HayMayia/Data/PROGRESS_LOG.md

# VocalBridge — Progress Log (continuation)

Updated: 12 Oct 2026 — HelpDetect V2.0 shipped (the sense -> speak merge).

## ✅ DONE 12 Oct — V2.0 closes the loop. This is the "v13" that was planned on 5 Sep and never built.
The 5 Sep NEXT STEPS list said, item 4:
> **Build v13** = clench detector + spoken "Help" through the MAX98357A (merge v11
> state machine + the playHelp() function from SpeakerSayHelp). Then: squeeze ->
> CLENCH! + "Help!". Film it (Phase-1 demo complete).

That merge never happened. It is done now — with one deliberate upgrade. The plan
was to merge the **v11 clench** state machine, but the project moved well past
clench detection in the six sessions since: HelpDetect V1.9 has a peak x duration
**word box** tuned on real HELP data, with auto-learn and flash persistence. So
V2.0 merges V1.9 (not v11) with the speaker. Same idea as v13, better detector.

Why this was the right gap to close — two firmware lines existed and never met:

| | senses the word | speaks it aloud | triggered by |
|---|---|---|---|
| `HelpDetect_AD8232` V1.9 | YES (tuned box + auto-learn) | NO — serial print only | the muscle signal |
| `SpeakerSayWords_MAX98357A` V5 | NO | YES (own voice, on-chip) | a keypress on a laptop |

Neither alone is VocalBridge. A sensed HELP now plays the 2-beep alert and says
"HELP!" in the user's own voice, standalone — no laptop, no Serial Monitor, no SD card.

How it was built (deliberately conservative):
- Audio engine + all four voice headers copied **verbatim** from V5, the build already
  verified on the real speaker. Nothing unproven was introduced. The hardware is
  confirmed good: 5 Sep logged "EXCHANGED BOARD WORKS... 'Help!' voice CONFIRMED
  WORKING too" after the original MAX98357A turned out to be a defective unit.
- Pins match the standardised wiring from 5 Sep exactly — BCLK 27 / LRC 26 / DIN 25,
  sensor OUT 34 / LO+ 32 / LO- 33. The 5 Sep note "no clash with sensor on 34" holds.
  LRC is on 26, **not** 33, so the "LO- must move to GPIO35" caveat does not apply.
- Detection logic **untouched**. `diff` vs V1.9 = 233 added / 10 removed lines, and
  every one of the 10 removed lines is comment or banner text. Same box
  (800-2000 x 150-1100 ms), same auto-learn, same flash save, same calibrate.
- Verified by compiling AND linking on **both** esp32 core paths (v2 `driver/i2s.h`,
  v3 `ESP_I2S.h`) against an Arduino/ESP32 stub harness: 0 errors, 0 warnings, and
  `setup()`+`loop()` execute clean. Harness sanity-checked by confirming known-good
  V1.9 passes it identically.
- Voice headers are `.h`, not `.ino`, so they sit safely in the sketch folder — the
  5 Sep warning that the Arduino IDE merges all `.ino` files in one folder does not bite.
- **NOT yet device-verified.** Standing rule: the user tests every build on the real
  speaker before it counts. That test is still outstanding.

New keys in V2.0 (all V1.9 keys unchanged, including `+/-` = HELP box edge):
- `1`/`2`/`3`/`4` say HELP/WATER/YES/NO by hand — speaker self-test and demo fallback
- `b` beep — fastest "is the speaker alive" check; splits "audio dead" from "never fired"
- `m` mute/unmute — for tuning and the statue test, when audio would only distract
- `[` `]` volume down/up (`+/-` were already taken by the box edge in V1.9)
- `t` test now prints **and** speaks, making it a true end-to-end check
- Boot still proves the audio path: 2 beeps + "HELP!" after 2 s, as V5 did

Engineering note — why playback needs a deaf window: `playClip()` blocks the loop for
~1.4 s, so ADC sampling stops, `env` goes stale, and the speaker's own vibration can
reach the pads. After every word V2.0 drops any burst in progress, keeps sampling so
`center` keeps tracking, refuses to open a new burst for `SPEAK_HOLD_MS` (600 ms), and
runs the 1500 ms refractory from the **end** of speech. Without this the device would
hear itself speak and re-trigger — the same class of self-inflicted false fire that
sessions 3 and 5 were ruined by.

## ✅ DONE 12 Oct — logs are now replayable offline
The log line gained two fields: `burst:` (the calibrated gate `burstLvl`) and `box:`
(the live peak x duration box). Older logs never recorded `burstLvl`, so sessions 1-6
could not be re-analysed offline without guessing the gate. Guessing fails badly: a
replay at any fixed gate merges everything into one enormous burst (measured apparent
durations of 20 500 ms — obviously not a word), and the reconstructed HELP count comes
out ~5x the real figure. Fields were appended, so the format stays backward-compatible.

## ⏭️ NEXT STEPS (in order)
1. **Flash V2.0 and confirm the speaker fires on a sensed HELP.** The one thing that
   cannot be done without hardware. Expect 2 beeps + "HELP!" at boot (that alone proves
   the audio path). Then `c` -> `CALIBRATE OK`, then say HELP -> expect the print *and*
   the voice. Prints but silent? press `b`, and check `m` is not muted.
2. Keep speaker wires away from pad wires — speaker current injects noise into the
   AD8232 (long-standing warning, still true).
3. **Collect WATER/YES/NO data.** Still COLLECT-ONLY, because there is nothing to build
   a box from: `Values.txt` (session 6) has 18 `MARK:HELP` and **0** `MARK:WATER`,
   `MARK:YES`, `MARK:NO`. Sessions 1-6 are HELP-only. Protocol (~10 min) is in
   ROADMAP.md. This is what finally stops "everything is HELP".
4. **Film the Phase-1 demo** — squeeze/say HELP -> device speaks. That was the point of
   v13 back on 5 Sep and is now reachable.
5. Then Phase 2: the "Tesla update" demo, adding PAIN over the air via ESP-NOW OTA.

---

## Historical entry — night of 5 Sep 2026 (speaker session, last one before exam week)

## 🔧 CURRENT DEBUGGING STATE (speaker wiring)
- LRC path FIXED (tone changes audible = BCLK/LRC/DIN all decoding). Which fix worked
  (fresh wire vs GPIO33) — still to be confirmed by user.
- Constant raspy/garbled sound **unchanged by the 256-step sine upgrade** → garble is
  PHYSICAL (marginal joint), not code. Suspect #1: amp header pins (possibly unsoldered
  from factory, like their AD8232 was).
- **NOW: user re-soldered the driver board — NO CHANGE.** Suspects remaining:
  ① speaker itself (battery pop test: wires on a 1.5V AA, clean pop = OK)
  ② amp clipping (volume `-`×5 test; fix = volume ≤8 or GAIN→VIN = 0dB)
  ③ dud amp clone (if ① ② pass → replace board)
- **✅ SOLVED (5 Sep, late): EXCHANGED BOARD WORKS.** Clean chime on SpeakerTest.
  The original unit was defective (lemon) — diagnosis chain (LRC isolation → re-solder
  → code fixes → exchange) validated. **"Help!" voice CONFIRMED WORKING too.**
- **Audio tuning (5 Sep, night):** user wanted louder + crisper →
  ① help_sound.h rebuilt as LOUD+CRISP edition (+4.7 dB loudness, HPF 170 Hz,
  presence +4.5 dB @ 2.6 kHz, soft limiter; same voice take). make_help_header.py
  now applies this chain automatically. Preview: audio/help_enhanced.wav.
  ② advised GAIN→GND wire (+3 dB) + VIN-on-5V check + speaker-in-a-box acoustic tip.
- ⚠️ IMPORTANT: the code pasted in chat (Sep 5) predates the APLL patch. For the new
  board, download the latest sketches from the `beep` branch on GitHub.
- Older context: garble with LRC dangling + all 6 Wire Doctor mappings failing →
  buzz splitter test isolated the fault to the LRC path (power/amp/speaker/BCLK/DIN
  were all confirmed good).
- When GPIO33 is taken by LRC, the muscle sensor's LO− moves to GPIO35 later.
- **Audio v5→v6 (mid-Sep):** v5 (STRETCH 3.0) reached the wanted slowness (2.64 s) but
  CACKLED — 3× exceeds the simple WSOLA's clean range. v6 fix: regenerate the take
  natively slow via elongated spellings ("Heeeelp! Heeeeelp, pleeeeease!", voice-02,
  1.49 s speech) + gentle 1.75× stretch → 2.81 s, RMS −8.1 dBFS, artifact delta +0.28%
  (clean). LESSON: keep stretch ≤ ~2×; make the source itself slow instead.
- **🔔 REVELATION (18 Sep):** user had been judging audio via the PREVIEW WAV on the
  COMPUTER — never uploaded anything after v5. Explains everything: v6/v7/v8 previews
  share the same take+speed (only ~1 dB deltas) → "sound is the same" was CORRECT on
  a computer; "weird on computer" = the speaker-mastered preview (18 dB compression
  + presence EQ) sounds harsh on full-range speakers BY DESIGN — it's mastered for
  the 2-inch driver + amp. Alarm beeps live in CODE, not in the preview.
  → Added audio/help_preview_natural.wav (same speed, no mastering) for fair listening.
  NEXT: user picks v10 variant by ear (computer previews), uploads that zip.
- **Audio v11 (23 Sep):** user verdict on v10: good but ① only the word "HELP"
  ② slight warble remains ③ 2.8x = "unnaturally slow, on purpose". v11: single
  plain "HELP" take (all 6 single-word TTS takes ~0.32s regardless of spelling —
  engine caps it) stretched only 1.8x → 0.77 s natural call pace, PV warble floor.
  Own-voice instructions added to guide (chat path + offline path). Single-word
  takes kept: audio/word_help1..6.wav (help6 = chosen, saved as help_single.wav).
- **Audio v10 (18 Sep):** user: "words slower, not the silence" → implemented a pure-
  python PHASE VOCODER (FFT + phase propagation + Laroche-Dolson identity phase
  locking) — the professional time-stretch. Two variants built from the two healthy
  takes (all 8 other TTS takes today were duds/punctuation-ignored — dud-rejection
  now in script): v10 classic ("Help! Help, please!" ×2.8, 2.49 s) and v10 help-me
  ("Please, help me! Help me!" ×2.6, 2.92 s, peak 0.83 take). Roughness + pitch-jitter
  metrics: PV ≈ WSOLA ≈ original (both clean by measurement); user's ears decide.
  Script now takes CLI args: take, stretch, out-header, version string.
- **Audio v9 (18 Sep, final approach):** user feedback on natural preview: elongated
  take "not the voice I chose" + still cackly → root causes: ① elongated spelling
  changes pronunciation character ② WSOLA on long vowels warbles ③ (hidden) all three
  new "pause" TTS takes were near-silent DUDS (peak 0.05-0.10). FIX: recovered the
  user-approved v3 take ("Help! Help, please!", peak 0.70) from git history,
  inserted 850 ms silence at detected word-boundary valleys — natural words, slow
  phrase, ZERO stretch. 2.56 s, active RMS −5 dB. Added dud-rejection (peak<0.25 =
  error) to make_help_header.py. help_voice_v9.h + SpeakerSayHelp_v9.zip pushed. (Earlier v8 countermeasures — new filename, boot banner with
  compile stamp, alarm intro, RMS −6.4 dBFS, volume 15 — all still apply and are
  exactly what makes the on-device test unambiguous.)
- **Status (mid-Sep):** audio system DONE (loud+crisp "Help!" confirmed). Exams nearly
  over (only Computers left). Next session: fresh pads → v13 (clench → "Help!") → film.

## 📍 Where the project stands

### ✅ DONE (previous sessions)
- **4095 saga solved** — root cause was floating OUTPUT wire / loose cable; soldered
  headers fixed it. Healthy AD8232 @3.3V reads ~2047 at rest (our "green light").
- **Electrodes** — green/RL on elbow bone (required), red+yellow on the same forearm
  muscle belly. LO+/LO- leads-off detection wired to GPIO32/33 and confirmed.
- **Muscle detection works** — clench shows up as slow baseline shift, dev up to 682
  (ball squeeze) / 1890 (max) vs rest noise ~39.
- **ClenchDetector v10** (ARMED→CLENCH!→SETTLE→re-ARM state machine) — works.
- **ClenchDetector v11** (weak-signal edition: 0.3 s windows, 2-quick-lines OR
  big-spike ≥3× threshold instant fire) — ready for dried-pad sessions.
- Full documentation set exists from the earlier session (SFVIP-format report, BOM,
  build guide, poster, video script, teammate guide, academy quiz site).

### 🆕 THIS SESSION (5 Sep, night)
User request (was rejected by the AI service last time, answered now):
> "give me a code to test if my speaker works using the provided speaker module and the driver"

**Hardware discovery:** the user's actual audio parts (from their own Amazon links in an
earlier chat) are a **MAX98357A I2S amplifier** (B0H99FVF3V) + **2″ 4Ω 5W speaker**
(Electronic Spices, B0BN44HPF9). NOT a DFPlayer — no microSD, no MP3 player, and
**digital input only** (a plain GPIO tone test gives silence on it).

Created `vocalbridge-speaker/`:
| File | Purpose |
|---|---|
| **`SpeakerTest_MAX98357A.ino`** | **The speaker test for THEIR board.** I2S beeps (880/440 Hz chime with click-free fades), no library, auto-detects esp32 core v2/v3. BCLK=27, LRC=26, DIN=25 (no clash with sensor on 34). Commands: b/+/-/h. |
| **`SpeakerWireDoctor.ino`** | **Wiring self-diagnosis.** For the "garbled sound that dies when LRC is plugged in" case: cycles 6 BCLK/LRC/DIN pin arrangements in software (swaps + one-hole shifts), chimes after each. When the chime is clean, the printed mapping = the actual wiring. No rewiring needed to diagnose. |
| **`SpeakerSayHelp_MAX98357A.ino`** | **Speaker SPEAKS "Help!"** — real voice clip embedded in the ESP32 flash (`help_sound.h`, AI voice chosen by the user in chat, 24 kHz mono 0.47 s, silence-trimmed + normalized). No SD card, no library. Commands: h play / 2 double / l loop / +− volume / b beep / i info. |
| `make_help_header.py` | Regenerates `help_sound.h` from `audio/help.wav` — lets the user put **their own voice** into the device. Tested working. |
| `SpeakerTest_DFPlayer.ino` | Plan B if a DFPlayer Mini is ever bought: status report, auto-play, serial commands, decoded errors. |
| `SpeakerTest_Tone_Amp.ino` | Plan C for plain analog amps (PAM8403 etc.): beep test. Does NOT work on MAX98357A (digital-only). |
| `ClenchDetector_v12_SPEAKER.ino` | v11 + DFPlayer = full Phase-1 demo **for the DFPlayer path**. Speaker optional at runtime. |
| `SPEAKER_TEST_GUIDE.md` | Start here: identify module (MAX98357A = Plan A = theirs), wiring, troubleshooting, EMG noise rules, next-week plan. |

### Key wiring standardized this session
```
MAX98357A (their board):  VIN->VIN(5V)  GND->GND  BCLK->GPIO27  LRC->GPIO26  DIN->GPIO25
                          SD & GAIN unconnected; speaker -> + / - output
DFPlayer (if ever bought): VCC->VIN(5V) GND->GND RX->GPIO26 TX->GPIO27 (crossed!)
                          Speaker -> SPK_1 + SPK_2 (never GND); SD: FAT32 /mp3/0001.mp3…
```

## ⏭️ NEXT STEPS (after exams)
1. Wire MAX98357A (5 wires + speaker) → run `SpeakerTest_MAX98357A.ino` → hear chime.
2. Run `SpeakerSayHelp_MAX98357A.ino` → hear the device SAY "Help!" ✅ (voice is on-chip)
3. **Fresh pads**, clench test again with v10/v11 → confirm CLENCH! still fires.
4. **Build v13** = clench detector + spoken "Help" through the MAX98357A
   (merge v11 state machine + the playHelp() function from SpeakerSayHelp).
   Then: squeeze → CLENCH! + "Help!". Film it (Phase-1 demo complete).
   Optional: generate Yes/No/Water/Pain voice clips the same way.
5. Then the real VocalBridge goal: jaw clench / swallow / tongue press with pads
   under the chin — check if those give a usable dev too.
6. Package updates: BOM, build guide, poster, report, video script (all exist;
   update with the MAX98357A speaker section).

**Note:** every sketch now lives in its own subfolder (Arduino IDE merges all .ino
files in one folder into one sketch — that would break the build).

## 🔍 HARDWARE AUTHENTICITY AUDIT (5 Sep, via Amazon listings)
- **MAX98357A board (B0H99FVF3V)**: Brand "**Generic**", ₹269 (fake MRP ₹399). Generic
  Chinese breakout (Adafruit-design copy — legal/normal). Chip authenticity lottery;
  theirs distorts constantly despite soldering + code fixes → **likely defective unit /
  reject-grade chip. ACTION: claim Amazon 10-day defective replacement, or pivot to
  DFPlayer Mini (code ready) / branded board (ROBODUINO, Robocraze SmartElex).**
- **Electronic Spices 2″ 4Ω 5W speaker (B0BN44HPF9)**: genuine Indian budget brand,
  ₹143, sold via Clicktech/Amazon — not fake, just cheap. Battery pop test = final check.
- **AD8232 (red SparkFun-style board)**: design clone (normal in India) but PROVEN
  working — rest ~2047, clench dev 682, leads-off OK. Fine.
- **ESP32 DevKit**: proven working across all sessions. Fine.
- **Spandan (Sunfox) ECG electrodes**: genuine medical brand. Fine (drying = normal wear).

## 📁 File history (for archaeology)
- `workspace-01a06757…/` (earlier session): docs, poster, report, academy, BOM+speaker plan
- `workspace-01a06d50…/` (4 Sep session): ADC_SelfTest, MuscleTest v2–v4,
  ClenchDetector v5–v11, VocalBridge_4095_FIX.md
- `vocalbridge-speaker/` (this session): speaker tests + v12 + guide
