HayMayia/Data/sensing_data/2026-09-29_session2_falsefires_vs_word_chart.png

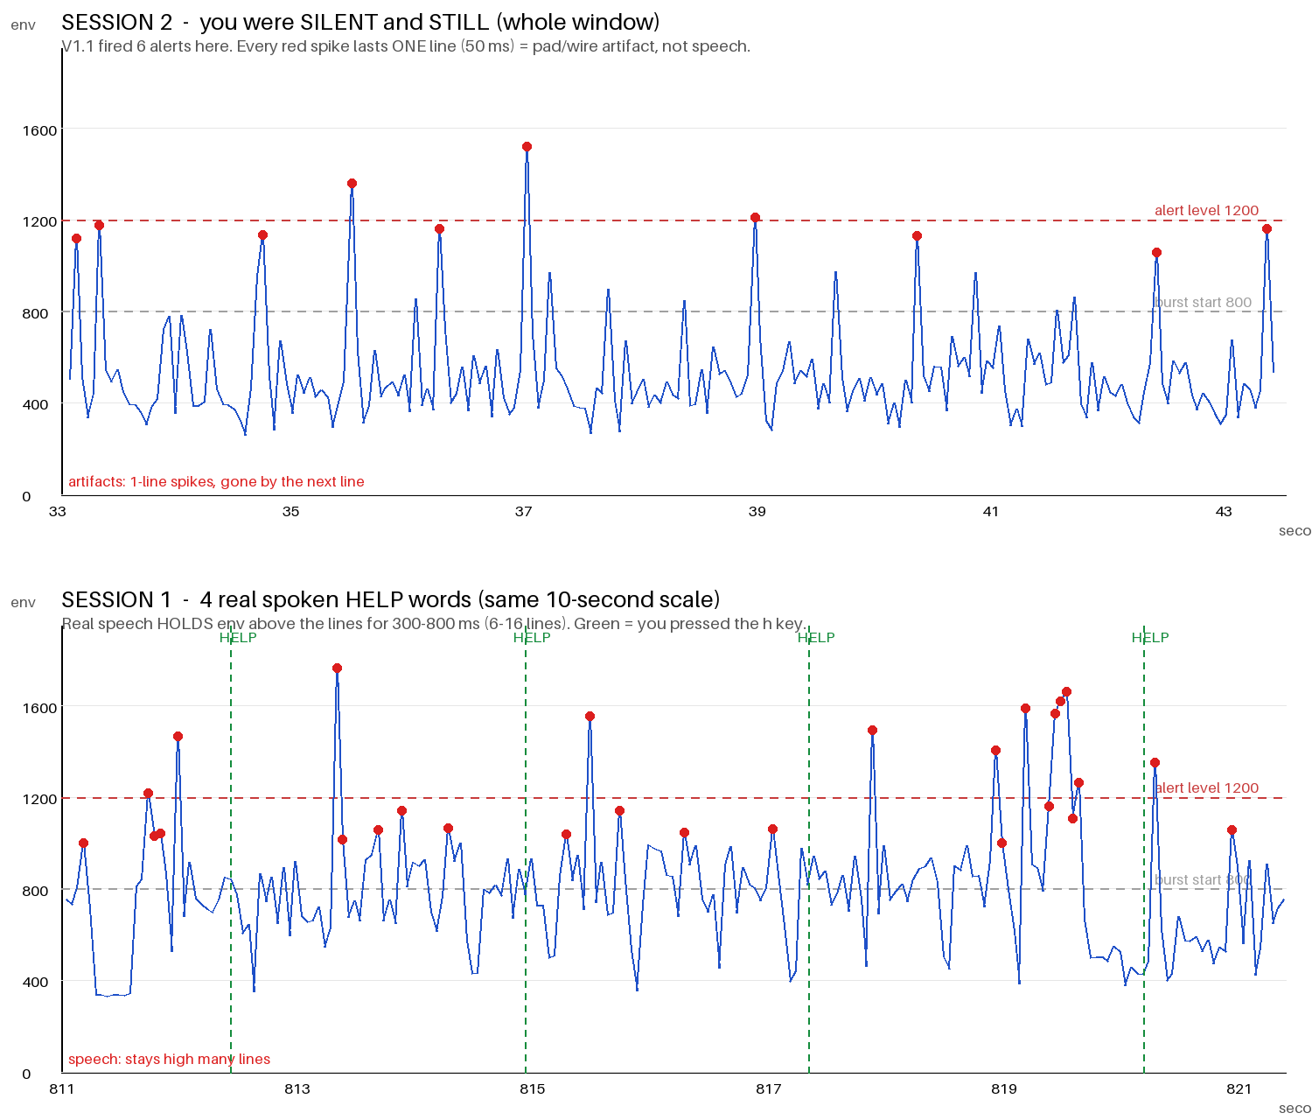
sensing_data/2026-09-29_session2_falsefires_vs_word_chart.png
