HayMayia/Data/sensing_data/2026-09-29_session3_neck_vs_session1_collarbone_chart.png

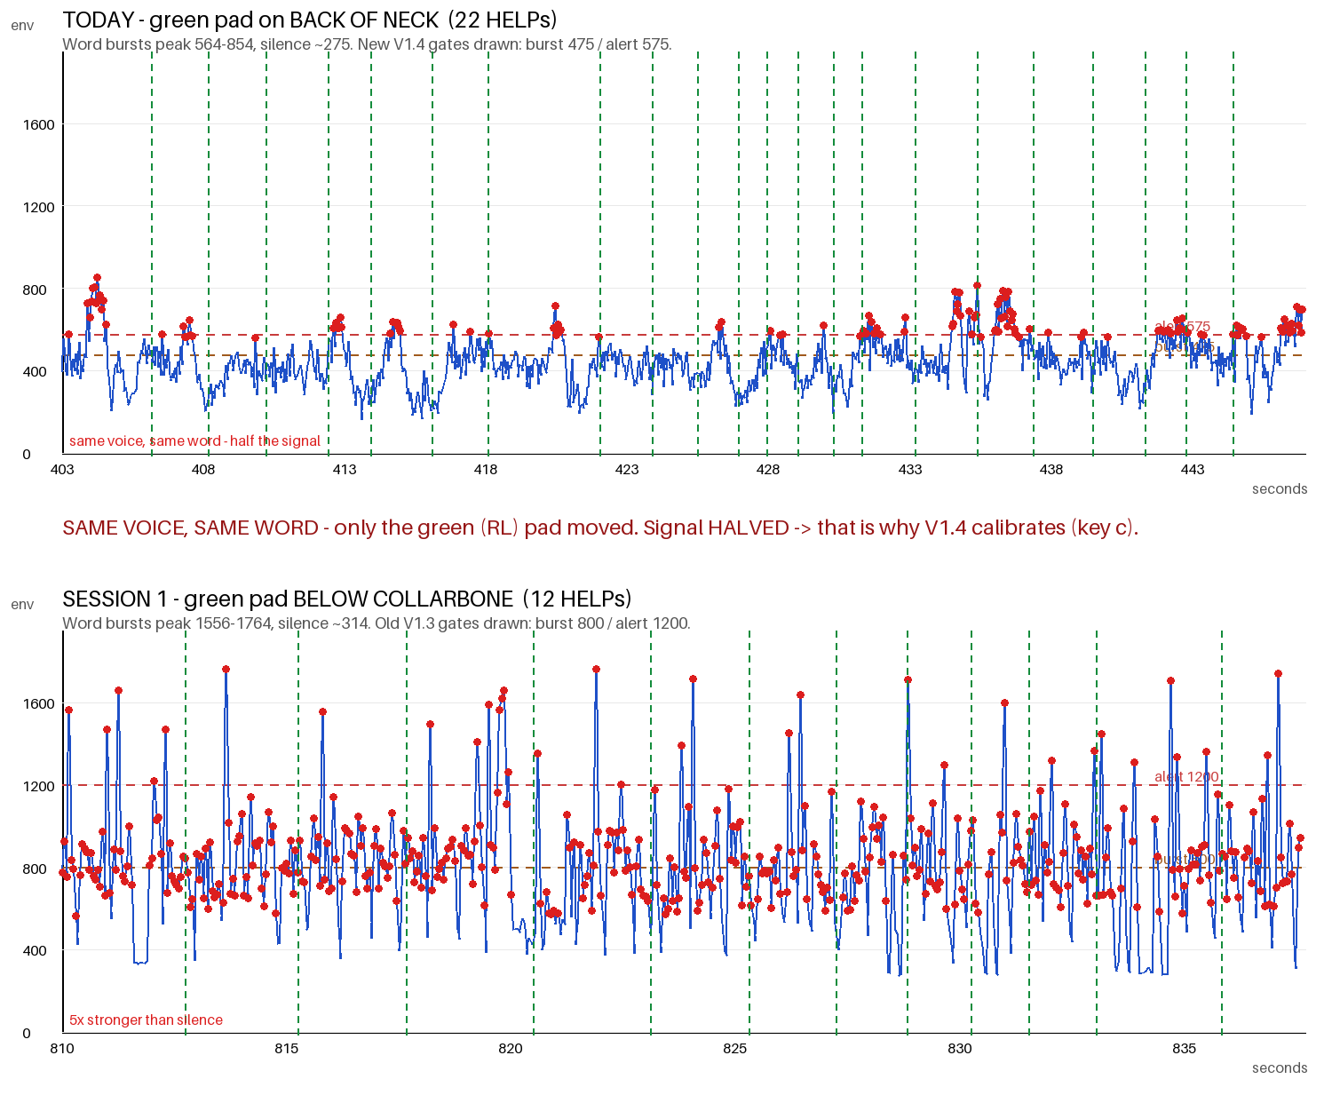
sensing_data/2026-09-29_session3_neck_vs_session1_collarbone_chart.png
