HayMayia/Data/sensing_data/session1_HELP_chart.png

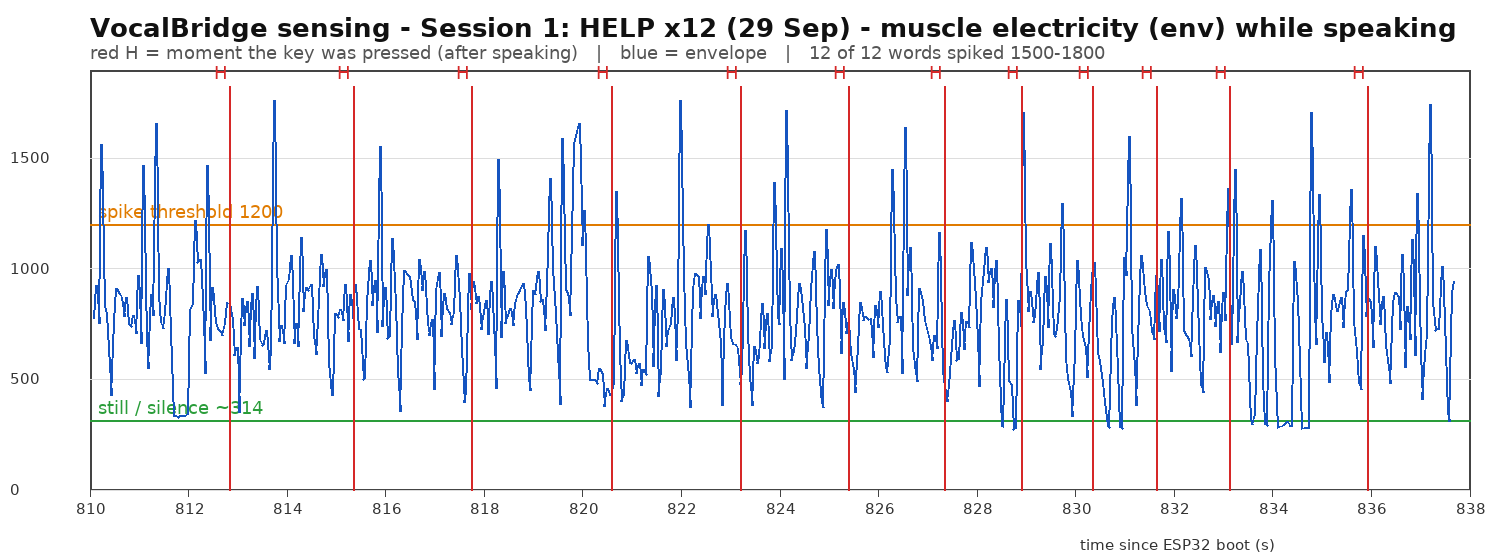
sensing_data/session1_HELP_chart.png
